spetroce/lgl3/kicad/parts/datasheets/seven_seg_footprint.png

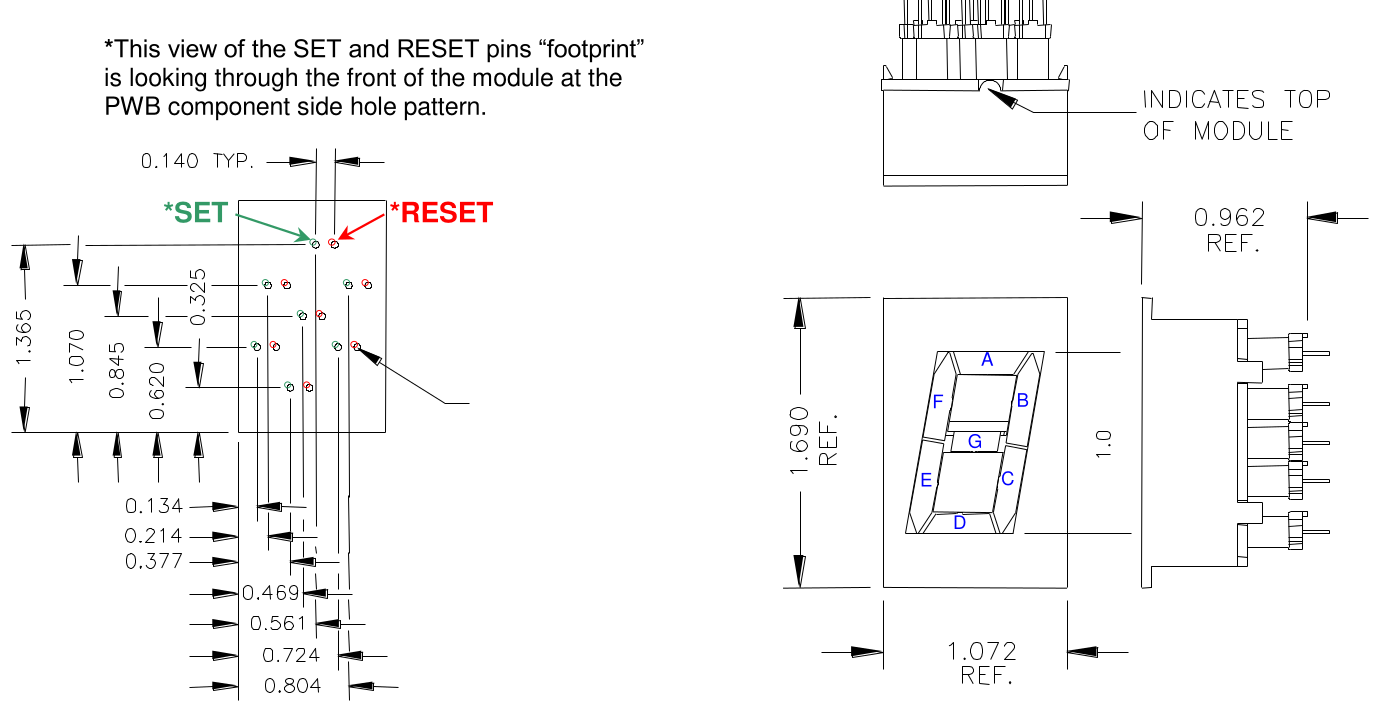
kicad/parts/datasheets/seven_seg_footprint.png
