spetroce/lgl3/(list of files, cad)

Other CAD files:
kicad/parts/3d_model/button_board.step
kicad/parts/3d_model/mcu_board.step
kicad/parts/3d_model/flip_dot_clock.step
kicad/parts/3d_model/SLC03B-05.step
kicad/parts/3d_model/UVR1H101MPD1TD.step
kicad/parts/3d_model/SOT23-5L_STM.step
kicad/parts/3d_model/NUCLEO-F303K8-HEADER v1.step
kicad/parts/3d_model/nucleo_interposer.step
kicad/parts/3d_model/SSOP24_3P90X8P65_ONS.step
kicad/parts/3d_model/EEUFR1H151B.step
kicad/parts/3d_model/apem-3eth9-15.0.step
kicad/parts/3d_model/STM32G431CBT6.step
kicad/parts/3d_model/alfa_zeta_small_seven_module v4.step
kicad/parts/3d_model/alfa_zeta_small_seven.step
kicad/parts/3d_model/NUCLEO-F303K8.step
kicad/parts/3d_model/ECS-327TXO-33-TR.step
kicad/parts/3d_model/95947A509_M3_45_11_Hex_Standoff.step
kicad/parts/3d_model/1053091205.step
kicad/parts/3d_model/436500216.step
kicad/parts/3d_model/91239A111_M3_6.step
