spetroce/lgl3/kicad/nucleo_interposer/nucleo_interposer.kicad_pcb

## KiCad design kicad/nucleo_interposer/nucleo_interposer.kicad_pcb (2023-02-04)

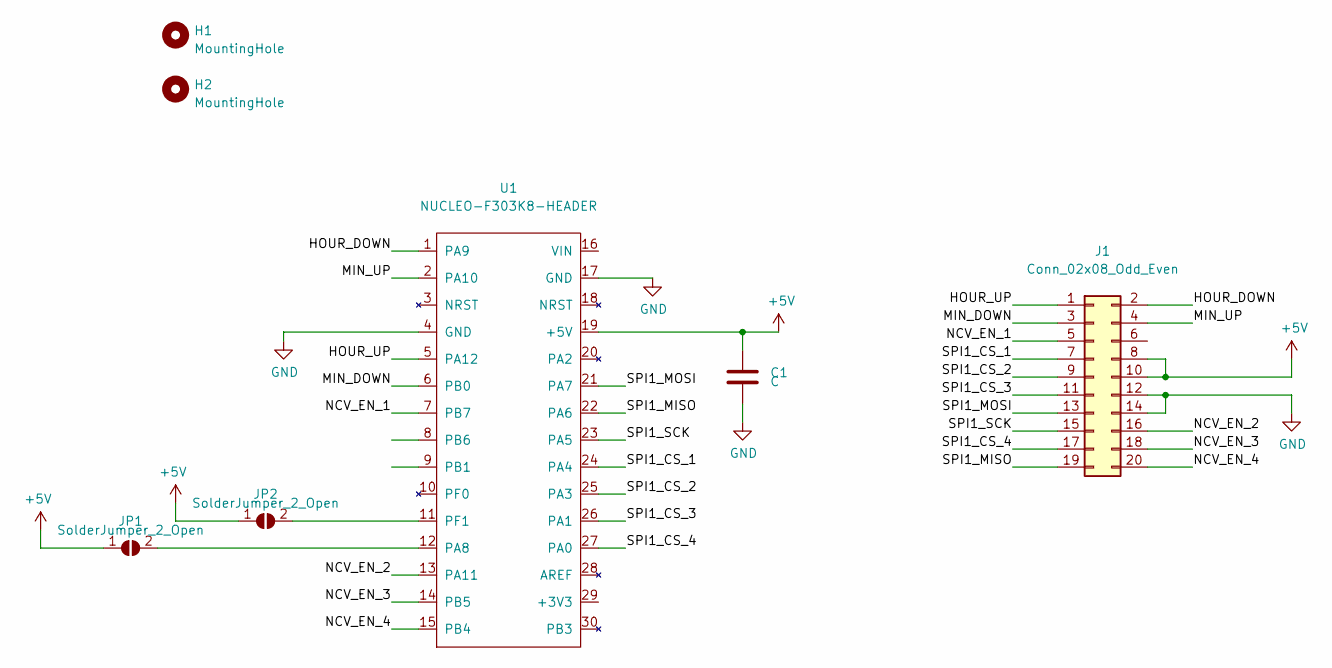
[picture p2: schematic nucleo_interposer.kicad_sch]

Parts:
C1: C; C_1206_3216Metric
H1, H2: MountingHole; MountingHole_3.2mm_M3
J1: Conn_02x08_Odd_Even; PinHeader_2x10_P2.54mm_Vertical
JP1, JP2: SolderJumper_2_Open; SolderJumper-2_P1.3mm_Open_TrianglePad1.0x1.5mm
U1: NUCLEO-F303K8-HEADER

Connections:
+5V: C1.2, J1.8, J1.10, JP1.1 (A), JP2.1 (A), U1.19 (+5V)
/HOUR_DOWN: J1.2, U1.1 (PA9)
/HOUR_UP: J1.1, U1.5 (PA12)
/MIN_DOWN: J1.3, U1.6 (PB0)
/MIN_UP: J1.4, U1.2 (PA10)
/NCV_EN_1: J1.5, U1.7 (PB7)
/NCV_EN_2: J1.16, U1.13 (PA11)
/NCV_EN_3: J1.18, U1.14 (PB5)
/NCV_EN_4: J1.20, U1.15 (PB4)
/SPI1_CS_1: J1.7, U1.24 (PA4)
/SPI1_CS_2: J1.9, U1.25 (PA3)
/SPI1_CS_3: J1.11, U1.26 (PA1)
/SPI1_CS_4: J1.17, U1.27 (PA0)
/SPI1_MISO: J1.19, U1.22 (PA6)
/SPI1_MOSI: J1.13, U1.21 (PA7)
/SPI1_SCK: J1.15, U1.23 (PA5)
GND: C1.1, J1.12, J1.14, U1.4 (GND), U1.17 (GND)
unnamed: JP1.2 (B), U1.12 (PA8)
unnamed: JP2.2 (B), U1.11 (PF1)

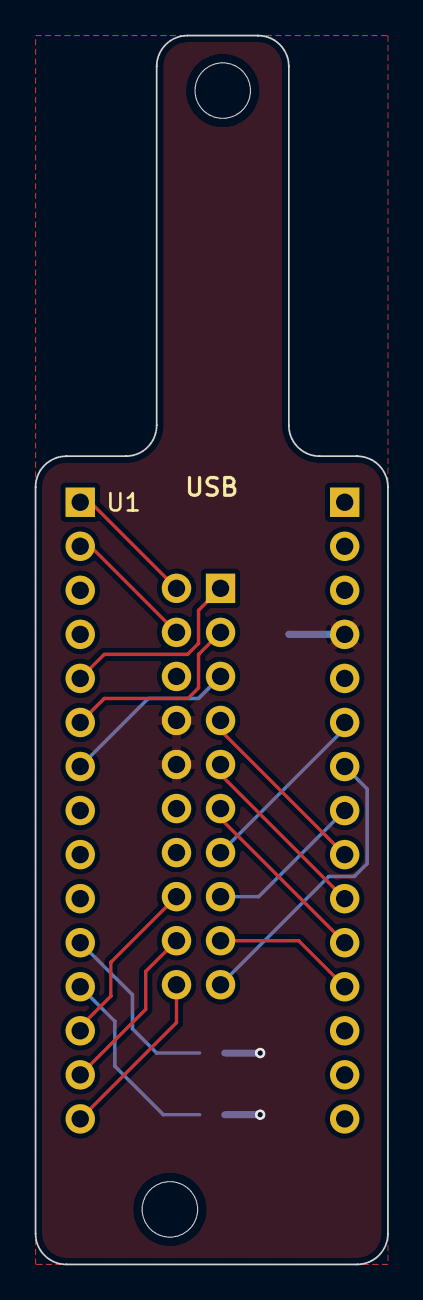
[picture p3: board nucleo_interposer.kicad_pcb from above]

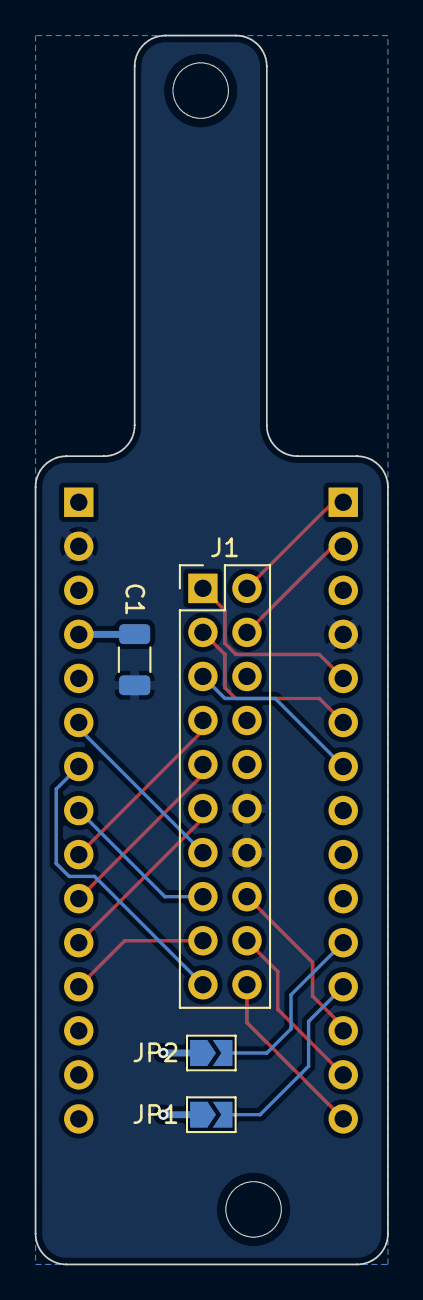
[picture p4: board nucleo_interposer.kicad_pcb from below]

Board: 2 copper layers, 20.3 x 70.9 mm, 7 parts (4 on the bottom side), 19 nets.
