spetroce/lgl3/kicad/button_board/button_board.kicad_pcb

## KiCad design kicad/button_board/button_board.kicad_pcb (2022-10-30)

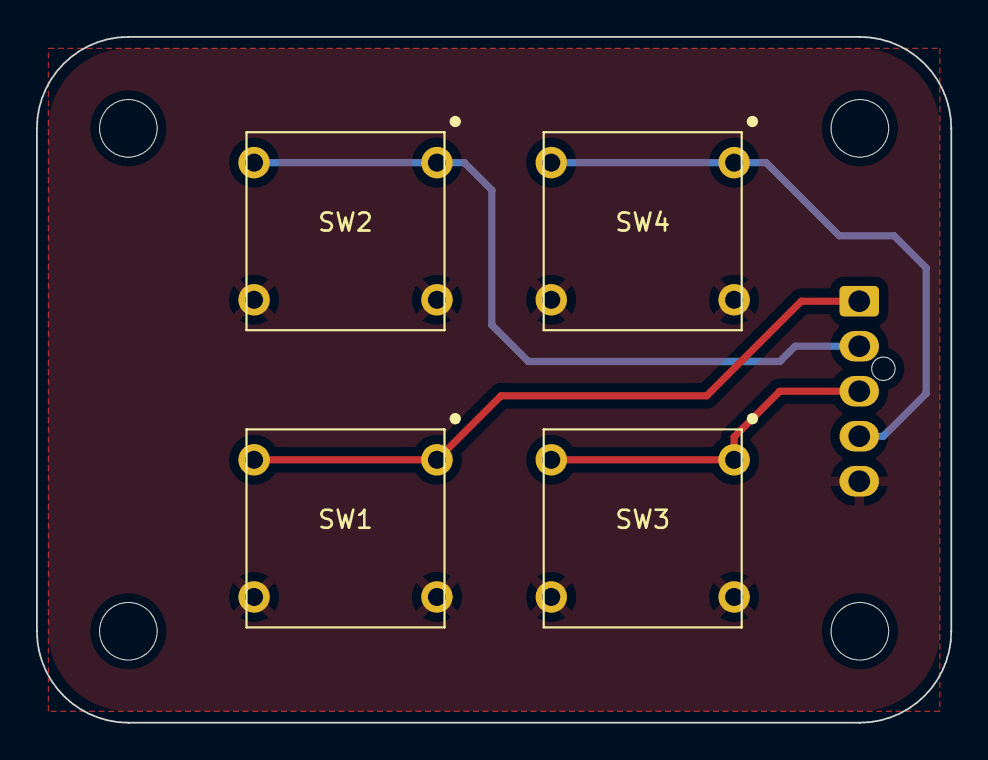
[picture p5: board button_board.kicad_pcb from above]

Board: 2 copper layers, 50.8 x 38.1 mm, 9 parts (1 on the bottom side), 5 nets.

Parts:
H1, H2, H3, H4: MountingHole; MountingHole_3.2mm_M3
J1: Conn_01x05_Male; Molex_Nano-Fit_105309-xx05_1x05_P2.50mm_Vertical
SW1, SW2, SW3, SW4: apem-3eth9-15.0; 3ETH9-15.0

Connections:
/HOUR_DOWN: J1.1, SW1.1, SW1.2
/HOUR_UP: J1.2, SW2.1, SW2.2
/MIN_DOWN: J1.3, SW3.1, SW3.2
/MIN_UP: J1.4, SW4.1, SW4.2
GND: J1.5, SW1.3, SW1.4, SW2.3, SW2.4, SW3.3, SW3.4, SW4.3, SW4.4
