spetroce/lgl3/kicad/mcu_board/mcu_board.kicad_pcb

## KiCad design kicad/mcu_board/mcu_board.kicad_pcb (2022-10-29)

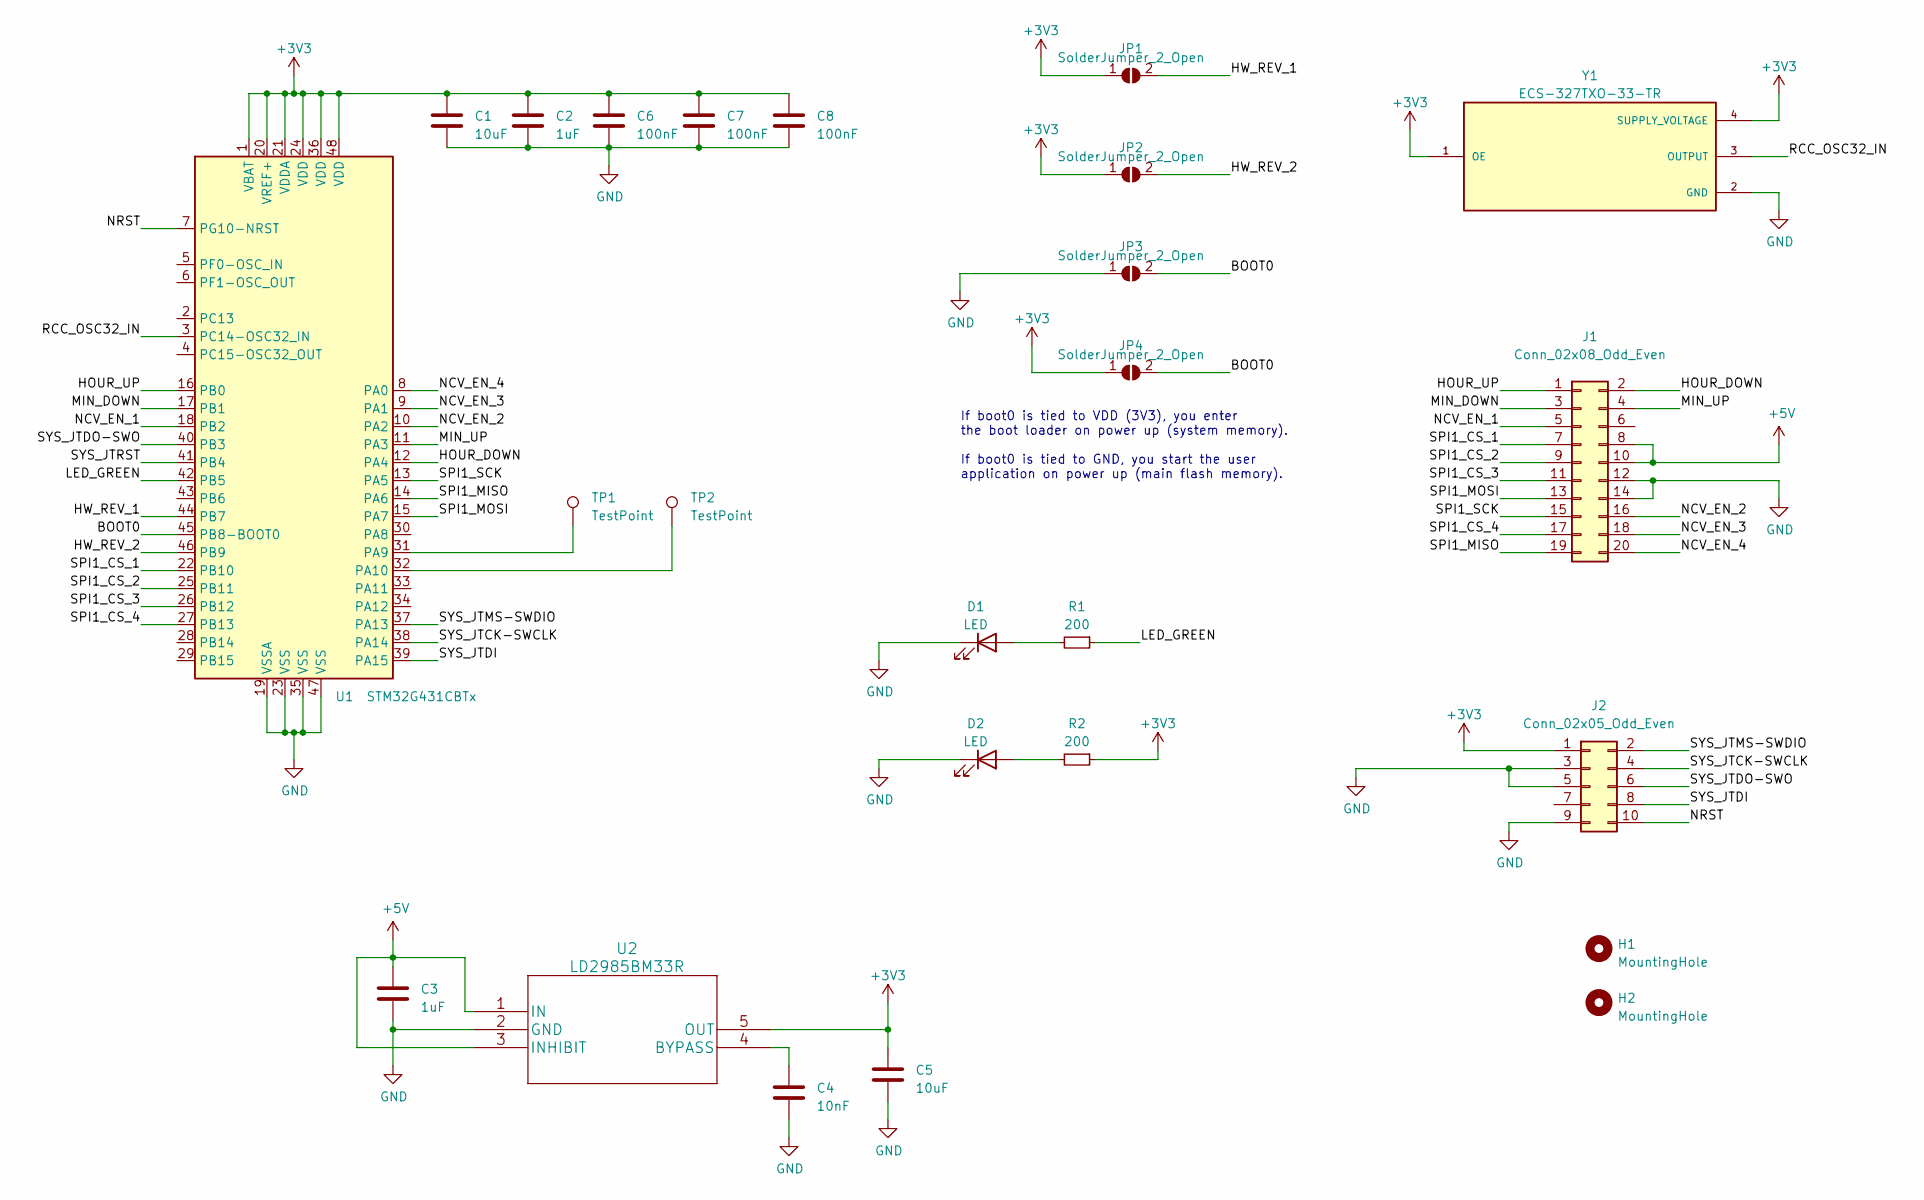
[picture p6: schematic mcu_board.kicad_sch]

Parts:
C1, C5: 10uF; C_0805_2012Metric; LCSC Part Number C32635
C2, C3: 1uF; C_0805_2012Metric; LCSC Part Number C107367
C4: 10nF; C_0603_1608Metric; LCSC Part Number C519405
C6, C7, C8: 100nF; C_0603_1608Metric; LCSC Part Number C184760
D1, D2: LED; LED_0603_1608Metric; LCSC Part Number C125093
H1, H2: MountingHole; MountingHole_3.2mm_M3
J1: Conn_02x08_Odd_Even; PinHeader_2x10_P2.54mm_Vertical
J2: Conn_02x05_Odd_Even; PinHeader_2x05_P1.27mm_Vertical
JP1, JP2, JP3, JP4: SolderJumper_2_Open; SolderJumper-2_P1.3mm_Open_TrianglePad1.0x1.5mm
R1, R2: 200; R_0603_1608Metric; LCSC Part Number C8218
TP1, TP2: TestPoint; TestPoint_Pad_D1.0mm
U1: STM32G431CBTx; LQFP-48_7x7mm_P0.5mm; LCSC Part Number C529355
U2: LD2985BM33R; SOT23-5L_STM; LCSC Part Number C222396
Y1: ECS-327TXO-33-TR; LCSC Part Number C2451198

Connections:
+3V3: C1.1, C2.2, C5.2, C6.1, C7.2, C8.1, J2.1, JP1.1 (A), JP2.1 (A), JP4.1 (A), R2.1, U1.1 (VBAT), U1.20 (VREF+), U1.21 (VDDA), U1.24 (VDD), U1.36 (VDD), U1.48 (VDD), U2.5 (OUT), Y1.1 (OE), Y1.4 (SUPPLY_VOLTAGE)
+5V: C3.2, J1.8, J1.10, U2.1 (IN), U2.3 (INHIBIT)
/BOOT0: JP3.2 (B), JP4.2 (B), U1.45 (PB8-BOOT0)
/HOUR_DOWN: J1.2, U1.12 (PA4)
/HOUR_UP: J1.1, U1.16 (PB0)
/HW_REV_1: JP1.2 (B), U1.44 (PB7)
/HW_REV_2: JP2.2 (B), U1.46 (PB9)
/LED_GREEN: R1.1, U1.42 (PB5)
/MIN_DOWN: J1.3, U1.17 (PB1)
/MIN_UP: J1.4, U1.11 (PA3)
/NCV_EN_1: J1.5, U1.18 (PB2)
/NCV_EN_2: J1.16, U1.10 (PA2)
/NCV_EN_3: J1.18, U1.9 (PA1)
/NCV_EN_4: J1.20, U1.8 (PA0)
/NRST: J2.10, U1.7 (PG10-NRST)
/RCC_OSC32_IN: U1.3 (PC14-OSC32_IN), Y1.3 (OUTPUT)
/SPI1_CS_1: J1.7, U1.22 (PB10)
/SPI1_CS_2: J1.9, U1.25 (PB11)
/SPI1_CS_3: J1.11, U1.26 (PB12)
/SPI1_CS_4: J1.17, U1.27 (PB13)
/SPI1_MISO: J1.19, U1.14 (PA6)
/SPI1_MOSI: J1.13, U1.15 (PA7)
/SPI1_SCK: J1.15, U1.13 (PA5)
/SYS_JTCK-SWCLK: J2.4, U1.38 (PA14)
/SYS_JTDI: J2.8, U1.39 (PA15)
/SYS_JTDO-SWO: J2.6, U1.40 (PB3)
/SYS_JTMS-SWDIO: J2.2, U1.37 (PA13)
/SYS_JTRST: U1.41 (PB4)
GND: C1.2, C2.1, C3.1, C4.1, C5.1, C6.2, C7.1, C8.2, D1.1 (K), D2.1 (K), J1.12, J1.14, J2.3, J2.5, J2.9, JP3.1 (A), U1.19 (VSSA), U1.23 (VSS), U1.35 (VSS), U1.47 (VSS), U2.2 (GND), Y1.2 (GND)
unnamed: D1.2 (A), R1.2
unnamed: D2.2 (A), R2.2
unnamed: TP1.1, U1.31 (PA9)
unnamed: TP2.1, U1.32 (PA10)
unnamed: C4.2, U2.4 (BYPASS)

Notes on the sheet:
If boot0 is tied to VDD (3V3), you enter the boot loader on power up (system memory). If boot0 is tied to GND, you start the user application on power up (main flash memory).

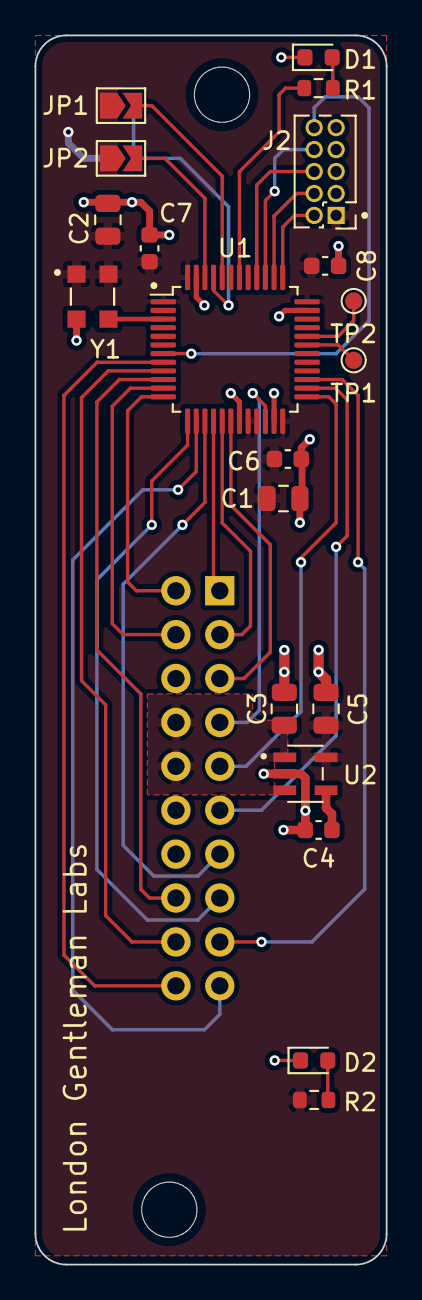
[picture p7: board mcu_board.kicad_pcb from above]

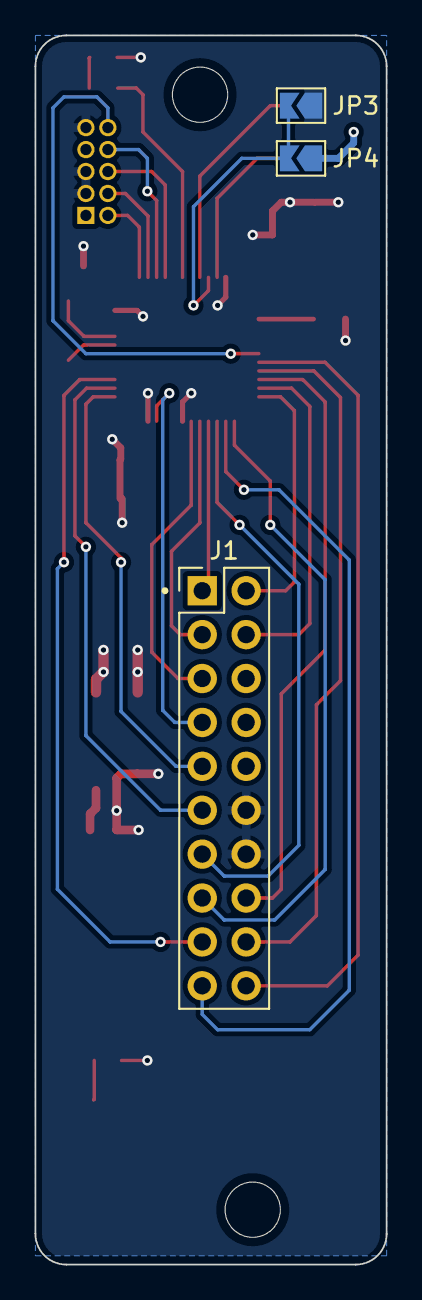
[picture p8: board mcu_board.kicad_pcb from below]

Board: 2 copper layers, 20.3 x 71.1 mm, 25 parts (3 on the bottom side), 33 nets.
