spetroce/lgl3/kicad/control/flip_dot_clock.kicad_pcb

## KiCad design kicad/control/flip_dot_clock.kicad_pcb (2022-10-29)

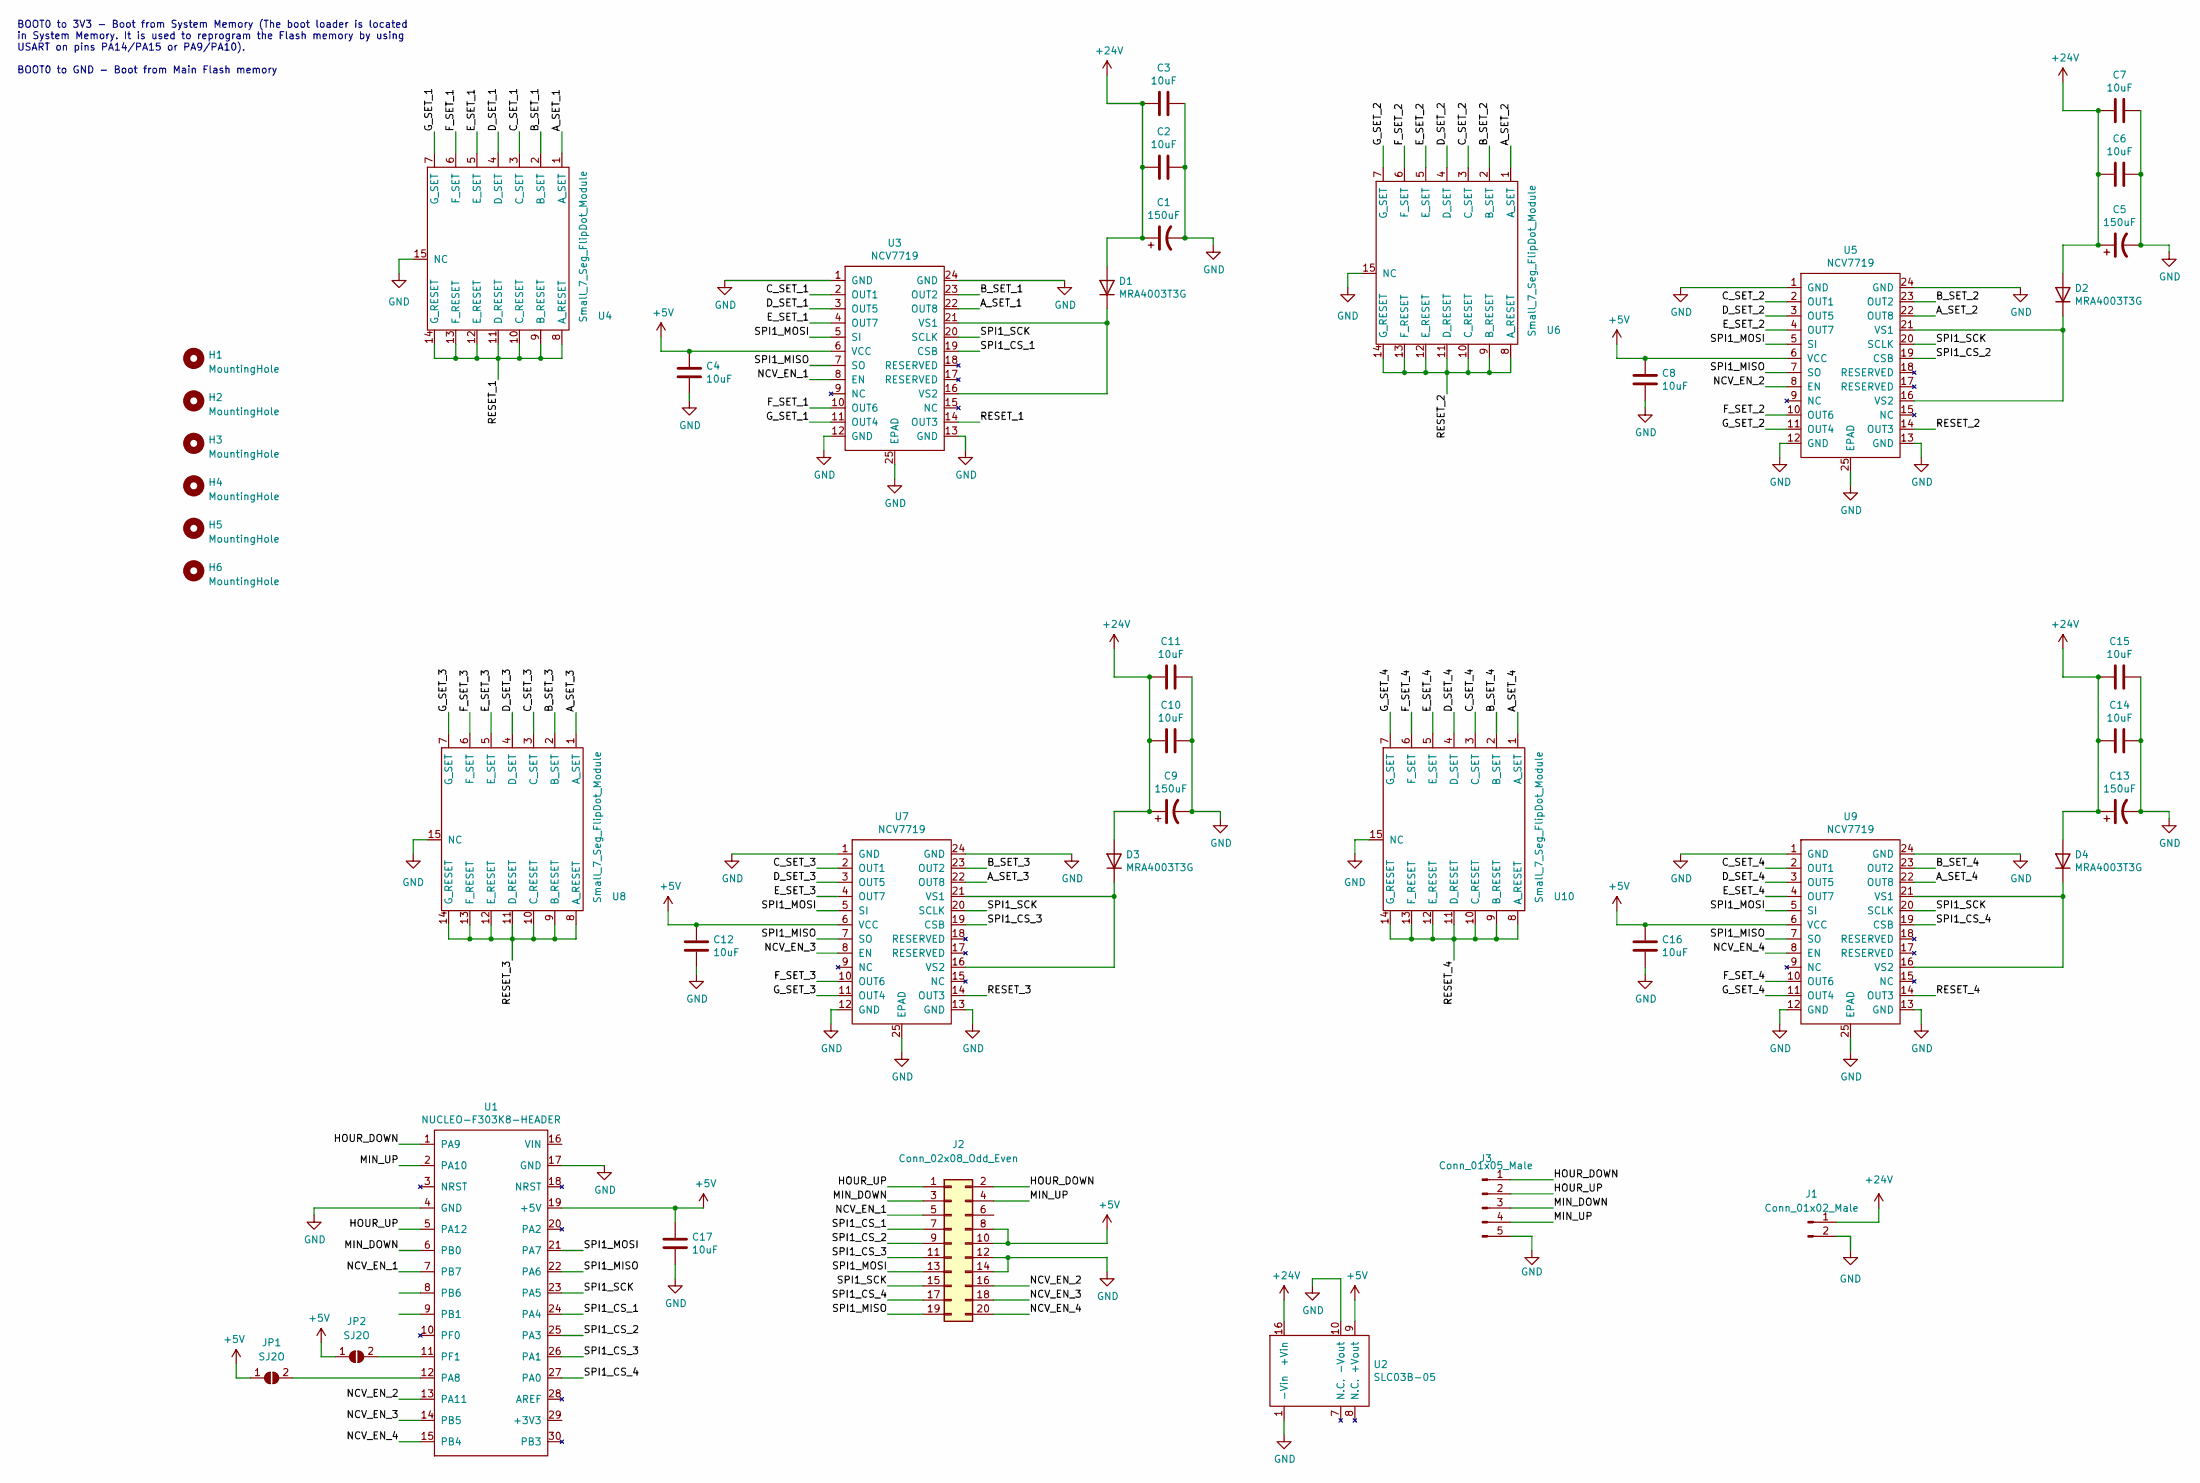
[picture p9: schematic flip_dot_clock.kicad_sch]

Parts:
C1, C5, C9, C13: 150uF; CP_Radial_D10.0mm_P5.00mm
C2, C3, C4, C6, C7, C8, C10, C11, C12, C14, C15, C16, C17: 10uF; C_1206_3216Metric
D1, D2, D3, D4: MRA4003T3G; D_SMA
H1, H2, H3, H4, H5, H6: MountingHole; MountingHole_3.2mm_M3
J1: Conn_01x02_Male; Molex_Micro-Fit_3.0_43650-0215_1x02_P3.00mm_Vertical
J2: Conn_02x08_Odd_Even; PinSocket_2x10_P2.54mm_Vertical
J3: Conn_01x05_Male; Molex_Nano-Fit_105309-xx05_1x05_P2.50mm_Vertical
JP1, JP2: SJ2O; SolderJumper-2_P1.3mm_Open_TrianglePad1.0x1.5mm
U1: NUCLEO-F303K8-HEADER
U2: SLC03B-05
U3, U5, U7, U9: NCV7719; SSOP-24_6.4x7.55mm_P0.65mm
U4, U6, U8, U10: Small_7_Seg_FlipDot_Module

Connections:
+5V: C4.1, C8.1, C12.1, C16.1, C17.1, J2.8, J2.10, JP1.1 (A), JP2.1 (A), U1.19 (+5V), U2.9 (+Vout), U3.6 (VCC), U5.6 (VCC), U7.6 (VCC), U9.6 (VCC)
+24V: C1.1, C2.2, C3.2, C5.1, C6.2, C7.2, C9.1, C10.2, C11.2, C13.1, C14.2, C15.2, D1.2 (A), D2.2 (A), D3.2 (A), D4.2 (A), J1.1, U2.16 (+Vin)
/A_SET_1: U3.22 (OUT8), U4.1 (A_SET)
/A_SET_2: U5.22 (OUT8), U6.1 (A_SET)
/A_SET_3: U7.22 (OUT8), U8.1 (A_SET)
/A_SET_4: U9.22 (OUT8), U10.1 (A_SET)
/B_SET_1: U3.23 (OUT2), U4.2 (B_SET)
/B_SET_2: U5.23 (OUT2), U6.2 (B_SET)
/B_SET_3: U7.23 (OUT2), U8.2 (B_SET)
/B_SET_4: U9.23 (OUT2), U10.2 (B_SET)
/C_SET_1: U3.2 (OUT1), U4.3 (C_SET)
/C_SET_2: U5.2 (OUT1), U6.3 (C_SET)
/C_SET_3: U7.2 (OUT1), U8.3 (C_SET)
/C_SET_4: U9.2 (OUT1), U10.3 (C_SET)
/D_SET_1: U3.3 (OUT5), U4.4 (D_SET)
/D_SET_2: U5.3 (OUT5), U6.4 (D_SET)
/D_SET_3: U7.3 (OUT5), U8.4 (D_SET)
/D_SET_4: U9.3 (OUT5), U10.4 (D_SET)
/E_SET_1: U3.4 (OUT7), U4.5 (E_SET)
/E_SET_2: U5.4 (OUT7), U6.5 (E_SET)
/E_SET_3: U7.4 (OUT7), U8.5 (E_SET)
/E_SET_4: U9.4 (OUT7), U10.5 (E_SET)
/F_SET_1: U3.10 (OUT6), U4.6 (F_SET)
/F_SET_2: U5.10 (OUT6), U6.6 (F_SET)
/F_SET_3: U7.10 (OUT6), U8.6 (F_SET)
/F_SET_4: U9.10 (OUT6), U10.6 (F_SET)
/G_SET_1: U3.11 (OUT4), U4.7 (G_SET)
/G_SET_2: U5.11 (OUT4), U6.7 (G_SET)
/G_SET_3: U7.11 (OUT4), U8.7 (G_SET)
/G_SET_4: U9.11 (OUT4), U10.7 (G_SET)
/HOUR_DOWN: J2.2, J3.1, U1.1 (PA9)
/HOUR_UP: J2.1, J3.2, U1.5 (PA12)
/MIN_DOWN: J2.3, J3.3, U1.6 (PB0)
/MIN_UP: J2.4, J3.4, U1.2 (PA10)
/NCV_EN_1: J2.5, U1.7 (PB7), U3.8 (EN)
/NCV_EN_2: J2.16, U1.13 (PA11), U5.8 (EN)
/NCV_EN_3: J2.18, U1.14 (PB5), U7.8 (EN)
/NCV_EN_4: J2.20, U1.15 (PB4), U9.8 (EN)
/RESET_1: U3.14 (OUT3), U4.8 (A_RESET), U4.9 (B_RESET), U4.10 (C_RESET), U4.11 (D_RESET), U4.12 (E_RESET), U4.13 (F_RESET), U4.14 (G_RESET)
/RESET_2: U5.14 (OUT3), U6.8 (A_RESET), U6.9 (B_RESET), U6.10 (C_RESET), U6.11 (D_RESET), U6.12 (E_RESET), U6.13 (F_RESET), U6.14 (G_RESET)
/RESET_3: U7.14 (OUT3), U8.8 (A_RESET), U8.9 (B_RESET), U8.10 (C_RESET), U8.11 (D_RESET), U8.12 (E_RESET), U8.13 (F_RESET), U8.14 (G_RESET)
/RESET_4: U9.14 (OUT3), U10.8 (A_RESET), U10.9 (B_RESET), U10.10 (C_RESET), U10.11 (D_RESET), U10.12 (E_RESET), U10.13 (F_RESET), U10.14 (G_RESET)
/SPI1_CS_1: J2.7, U1.24 (PA4), U3.19 (CSB)
/SPI1_CS_2: J2.9, U1.25 (PA3), U5.19 (CSB)
/SPI1_CS_3: J2.11, U1.26 (PA1), U7.19 (CSB)
/SPI1_CS_4: J2.17, U1.27 (PA0), U9.19 (CSB)
/SPI1_MISO: J2.19, U1.22 (PA6), U3.7 (SO), U5.7 (SO), U7.7 (SO), U9.7 (SO)
/SPI1_MOSI: J2.13, U1.21 (PA7), U3.5 (SI), U5.5 (SI), U7.5 (SI), U9.5 (SI)
/SPI1_SCK: J2.15, U1.23 (PA5), U3.20 (SCLK), U5.20 (SCLK), U7.20 (SCLK), U9.20 (SCLK)
GND: C1.2, C2.1, C3.1, C4.2, C5.2, C6.1, C7.1, C8.2, C9.2, C10.1, C11.1, C12.2, C13.2, C14.1, C15.1, C16.2, C17.2, J1.2, J2.12, J2.14, J3.5, U1.4 (GND), U1.17 (GND), U2.1 (-Vin), U2.10 (-Vout), U3.1 (GND), U3.12 (GND), U3.13 (GND), U3.24 (GND), U3.25 (EPAD), U4.15 (NC), U5.1 (GND), U5.12 (GND), U5.13 (GND), U5.24 (GND), U5.25 (EPAD), U6.15 (NC), U7.1 (GND), U7.12 (GND), U7.13 (GND), U7.24 (GND), U7.25 (EPAD), U8.15 (NC), U9.1 (GND), U9.12 (GND), U9.13 (GND), U9.24 (GND), U9.25 (EPAD), U10.15 (NC)
unnamed: D1.1 (K), U3.16 (VS2), U3.21 (VS1)
unnamed: D2.1 (K), U5.16 (VS2), U5.21 (VS1)
unnamed: D3.1 (K), U7.16 (VS2), U7.21 (VS1)
unnamed: D4.1 (K), U9.16 (VS2), U9.21 (VS1)
unnamed: JP1.2 (B), U1.12 (PA8)
unnamed: JP2.2 (B), U1.11 (PF1)

Notes on the sheet:
BOOT0 to 3V3 - Boot from System Memory (The boot loader is located in System Memory. It is used to reprogram the Flash memory by using USART on pins PA14/PA15 or PA9/PA10). BOOT0 to GND - Boot from Main Flash memory

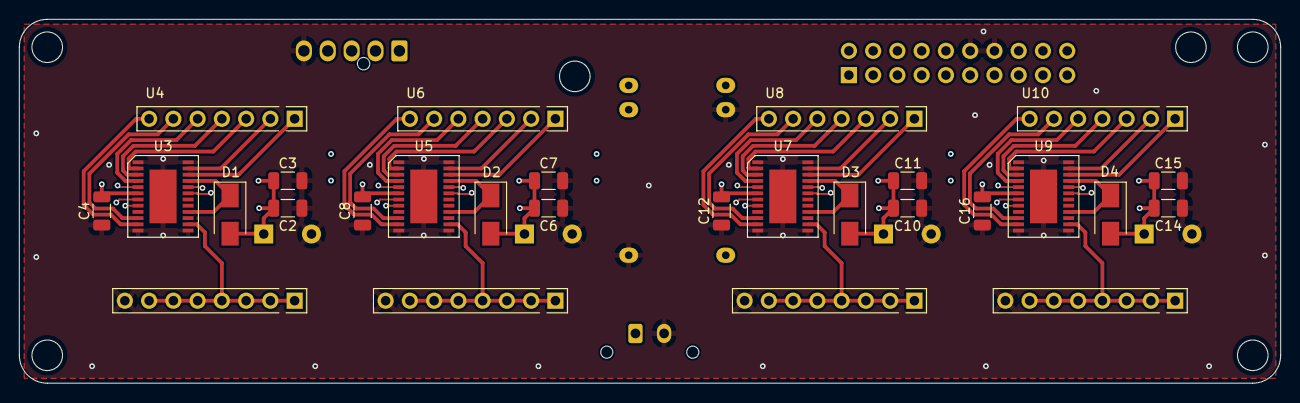
[picture p10: board flip_dot_clock.kicad_pcb from above]

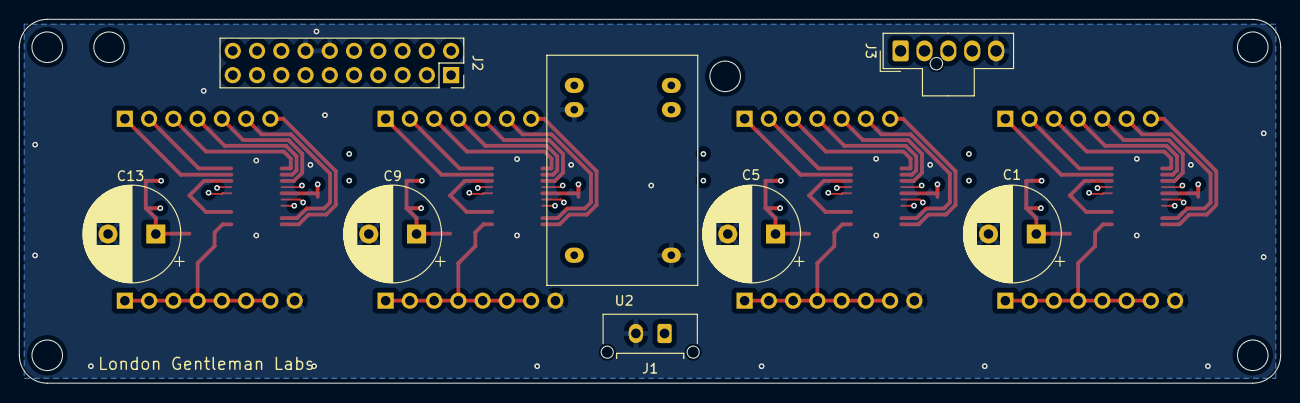
[picture p11: board flip_dot_clock.kicad_pcb from below]

Board: 4 copper layers, 132.1 x 38.1 mm, 38 parts (10 on the bottom side), 54 nets.
