spetroce/lgl3/kicad/digit_holder/digit_holder.kicad_pcb

## KiCad design kicad/digit_holder/digit_holder.kicad_pcb (2022-10-17)

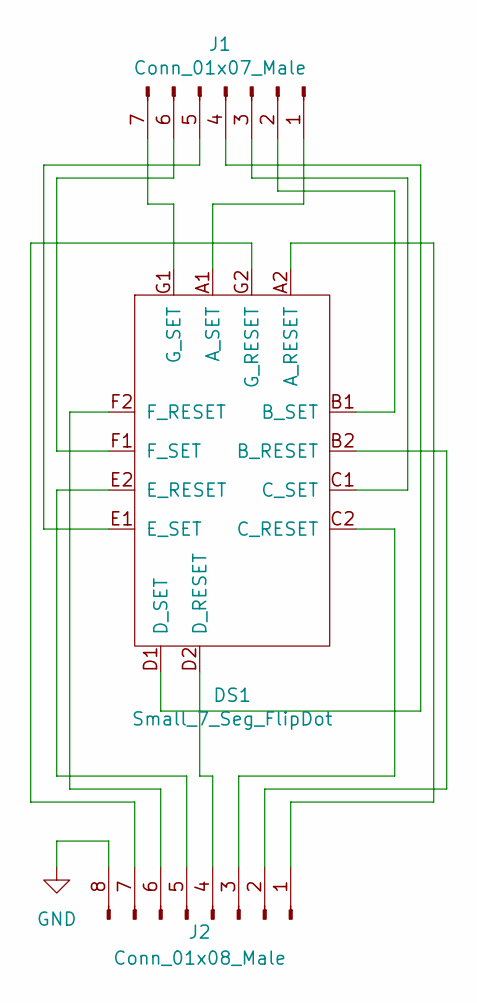
[picture p12: schematic digit_holder.kicad_sch]

Parts:
DS1: Small_7_Seg_FlipDot
J1: Conn_01x07_Male; PinHeader_1x07_P2.54mm_Vertical
J2: Conn_01x08_Male; PinHeader_1x08_P2.54mm_Vertical

Connections:
GND: J2.8
unnamed: DS1.A2 (A_RESET), J2.1
unnamed: DS1.A1 (A_SET), J1.1
unnamed: DS1.B2 (B_RESET), J2.2
unnamed: DS1.B1 (B_SET), J1.2
unnamed: DS1.C2 (C_RESET), J2.3
unnamed: DS1.C1 (C_SET), J1.3
unnamed: DS1.D2 (D_RESET), J2.4
unnamed: DS1.D1 (D_SET), J1.4
unnamed: DS1.E2 (E_RESET), J2.5
unnamed: DS1.E1 (E_SET), J1.5
unnamed: DS1.F2 (F_RESET), J2.6
unnamed: DS1.F1 (F_SET), J1.6
unnamed: DS1.G2 (G_RESET), J2.7
unnamed: DS1.G1 (G_SET), J1.7

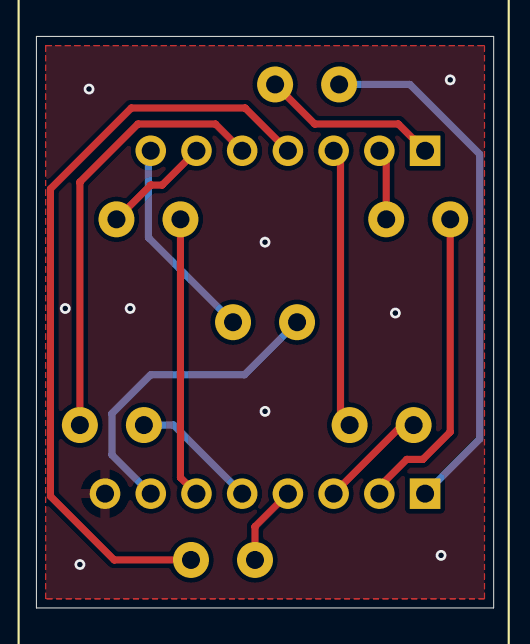
[picture p13: board digit_holder.kicad_pcb from above]

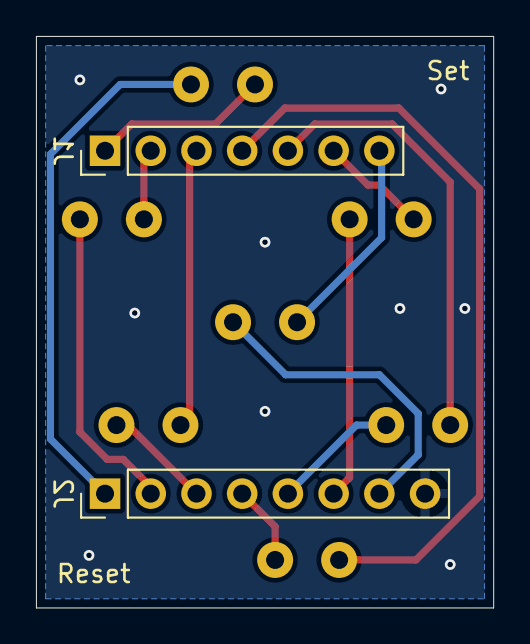
[picture p14: board digit_holder.kicad_pcb from below]

Board: 2 copper layers, 25.4 x 31.8 mm, 3 parts (2 on the bottom side), 14 nets.
