spetroce/lgl3/firmware/Core/Inc/main.h

#define NCV_EN_4_Pin GPIO_PIN_0
#define NCV_EN_4_GPIO_Port GPIOA
#define NCV_EN_3_Pin GPIO_PIN_1
#define NCV_EN_3_GPIO_Port GPIOA
#define NCV_EN_2_Pin GPIO_PIN_2
#define NCV_EN_2_GPIO_Port GPIOA
#define HOUR_DOWN_Pin GPIO_PIN_3
#define HOUR_DOWN_GPIO_Port GPIOA
#define MIN_UP_Pin GPIO_PIN_4
#define MIN_UP_GPIO_Port GPIOA
#define HOUR_UP_Pin GPIO_PIN_0
#define HOUR_UP_GPIO_Port GPIOB
#define MIN_DOWN_Pin GPIO_PIN_1
#define MIN_DOWN_GPIO_Port GPIOB
#define NCV_EN_1_Pin GPIO_PIN_2
#define NCV_EN_1_GPIO_Port GPIOB
#define SPI1_CS_1_Pin GPIO_PIN_10
#define SPI1_CS_1_GPIO_Port GPIOB
#define SPI1_CS_2_Pin GPIO_PIN_11
#define SPI1_CS_2_GPIO_Port GPIOB
#define SPI1_CS_3_Pin GPIO_PIN_12
#define SPI1_CS_3_GPIO_Port GPIOB
#define SPI1_CS_4_Pin GPIO_PIN_13
#define SPI1_CS_4_GPIO_Port GPIOB
#define LED_GREEN_Pin GPIO_PIN_5
#define LED_GREEN_GPIO_Port GPIOB
#define HW_REV_1_Pin GPIO_PIN_7
#define HW_REV_1_GPIO_Port GPIOB
#define HW_REV_2_Pin GPIO_PIN_9
#define HW_REV_2_GPIO_Port GPIOB
