spetroce/lgl3/(commit log)

2019-12-18 lgl3 - flip dot clock
    [flip_dot_clock.kicad_pcb, flip_dot_clock.sch]
2019-12-18 add datasheets
    [flip_dot_clock.sch]
2020-02-24 update MCU. update kicad project.
    [flip_dot_clock.sch]
2021-05-27 move to kicad folder
    [flip_dot_clock.kicad_pcb, flip_dot_clock.sch]
2021-05-27 add SPI
2021-05-27 restart kicad project
    [flip_dot_clock.kicad_pcb, flip_dot_clock.sch]
2021-08-01 update driver, debug LED, bunch of improvements
2021-08-01 get SPI working and timed correctly
    [flip_dot_clock.ioc, main.c, main.h]
2021-08-02 update SPI settings
2021-08-05 change SPI to LL library
    Noticed that there was a lot of latency in the HAL transmit
    function. It was taking 35us to send two words, with a 5us delay
    in between them. The acutal transmissions take up 7.75us. So that's
    22.25us of delay or roughly 5.55us before and after a chip select
    line toggle. With the LL drivers, the total transmit time is 17us.
    That makes for rougly 1.1us before and after a chip select line
    toggle. The use of the LL driver has doubled this SPI transmission
    performance.
2021-08-18 rewrite
    Turns out the ncv7719 chip can only drive two segments at a time.
    All operations have been updated to switch a maximum of two
    segments now. There is a global tx_data buffer and a parallel
    disp_idx buffer that are used to store command sequences. No more
    state machines for setting digits or for showing/hiding all
    segments.
2021-09-20 seven segment holder pcb
    [GCM21BR91H104KA37L.step, GRM21BR6YA106KE43L.step, digit_holder.kicad_pcb, digit_holder.sch, flip_dot_clock.sch]
2021-09-23 update pcb
    [digit_holder.kicad_pcb]
2021-11-08 add parts
    [NUCLEO-F303K8-HEADER v1.step, SLC03B-05.stp, alfa_zeta_small_seven_module v4.step, flip_dot_clock.sch]
2021-11-08 new footprint
2021-11-08 update schem
    [flip_dot_clock.sch]
2021-11-14 update parts. add caps
    [EEUFR1H151B.STEP, EEUFR1H151B.step, GCM21BR91H104KA37L.step, GRM21BR6YA106KE43L.step, flip_dot_clock.sch]
2021-12-27 update parts
    [EEUFR1H151B.step, SSOP24_3P90X8P65_ONS.step, UVR1H101MPD1TD.step, flip_dot_clock.kicad_pcb, flip_dot_clock.sch]
2021-12-29 update stm driver
2021-12-30 pcb updates
    [flip_dot_clock.kicad_pcb, flip_dot_clock.kicad_sch]
2021-12-30 add power planes
    [flip_dot_clock.kicad_pcb]
2022-01-01 all PCB nets connected
    [flip_dot_clock.kicad_pcb, flip_dot_clock.kicad_sch]
2022-01-01 update footprints, adjust power planes
    [flip_dot_clock.kicad_pcb]
2022-01-01 update power planes, move C17, update EN pin mux
    [flip_dot_clock.kicad_pcb]
2022-01-02 DRC updates
    [flip_dot_clock.kicad_pcb, flip_dot_clock.kicad_sch]
2022-01-02 update layout, add power connector
    [436500216.stp, flip_dot_clock.kicad_pcb, flip_dot_clock.kicad_sch]
2022-01-09 begin PCB redesign based on overall clock dims
    [flip_dot_clock.kicad_pcb]
2022-01-09 adjust power planes
    [flip_dot_clock.kicad_pcb]
2022-01-16 fix all the kicad files
    [flip_dot_clock.kicad_pcb, flip_dot_clock.kicad_sch, flip_dot_clock.sch]
2022-02-02 moving along
    [1053091205.stp, flip_dot_clock.kicad_pcb, flip_dot_clock.kicad_sch]
2022-02-02 update firmware to match new digit layout
    I let the PCB layout dictate the pinout for the NCV driver chip to have
    a more elegant trace layout. This required updating the bitmasks for
    setting the segments and digits.
2022-02-02 flip schematic part
    [flip_dot_clock.kicad_sch]
2022-02-05 kicad update
    [flip_dot_clock.kicad_pcb, flip_dot_clock.kicad_sch]
2022-02-05 add nucleo interposer board
    [nucleo_interposer.kicad_pcb, nucleo_interposer.kicad_sch]
2022-02-05 update tracks
    [nucleo_interposer.kicad_pcb]
2022-02-05 add nucleo interposer step and make it smaller
    [flip_dot_clock.kicad_pcb, nucleo_interposer.kicad_pcb, nucleo_interposer.step]
2022-02-05 move JPS and cap to back
    [flip_dot_clock.kicad_pcb, nucleo_interposer.kicad_pcb, nucleo_interposer.step]
2022-02-07 add digit holder ground planes
    [digit_holder.kicad_pcb, digit_holder.kicad_sch, digit_holder.sch, flip_dot_clock.kicad_pcb, flip_dot_clock.kicad_sch]
2022-02-08 add mounts for nucleo interposer
    [94669A306_Aluminum Unthreaded Spacer.STEP, flip_dot_clock.kicad_pcb, nucleo_interposer.kicad_pcb, nucleo_interposer.step]
2022-02-18 and more ground plane
    [flip_dot_clock.kicad_pcb]
2022-02-19 fill zone update
    [flip_dot_clock.kicad_pcb]
2022-02-20 add button board. update control ground plane.
    [button_board.kicad_pcb, button_board.kicad_sch, flip_dot_clock.kicad_pcb, flip_dot_clock.kicad_sch]
2022-02-20 increase track/clearance size
    [button_board.kicad_pcb]
2022-03-03 update kicad
    [flip_dot_clock.kicad_pcb]
2022-04-16 button repeat
2022-10-03 update mcu to stm32g431cbt6 and add tcxo
    [ECS-327TXO-33-TR.step, SOT23-5L_STM.step, STM32G431CBT6.step, flip_dot_clock.kicad_pcb, mcu_board.kicad_pcb, mcu_board.kicad_sch]
2022-10-10 update 3d models
    [flip_dot_clock.kicad_pcb, mcu_board.kicad_pcb]
2022-10-11 fix LDO bug. FW updates to support new HW
    [mcu_board.kicad_pcb, mcu_board.kicad_sch]
2022-10-11 use 100nF 0603 for bypass cap
    [mcu_board.kicad_pcb, mcu_board.kicad_sch]
2022-10-11 rework LDO section
    [mcu_board.kicad_pcb, mcu_board.kicad_sch]
2022-10-14 layout update for LDO
    [mcu_board.kicad_pcb, mcu_board.kicad_sch]
2022-10-17 update 3d model paths
    [1053091205.step, 1053091205.stp, 436500216.step, 436500216.stp, 91239A111_M3_6.STEP, 91239A111_M3_6.step, 95947A006_M3_45_10_Hex_Standoff.STEP, 95947A006_M3_45_10_Hex_Standoff.step]
2022-10-30 add button_board step
    [button_board.kicad_pcb, button_board.step]
2022-10-30 fix button_board step
    [button_board.step]
2023-01-04 move buttons to match clock assembly update
2023-02-04 update kicad version
    [button_board.kicad_sch, flip_dot_clock.kicad_sch, mcu_board.kicad_sch, nucleo_interposer.kicad_pcb, nucleo_interposer.kicad_sch]
